kinnison/macadamia/proto1/Lumberg-010599_06.step

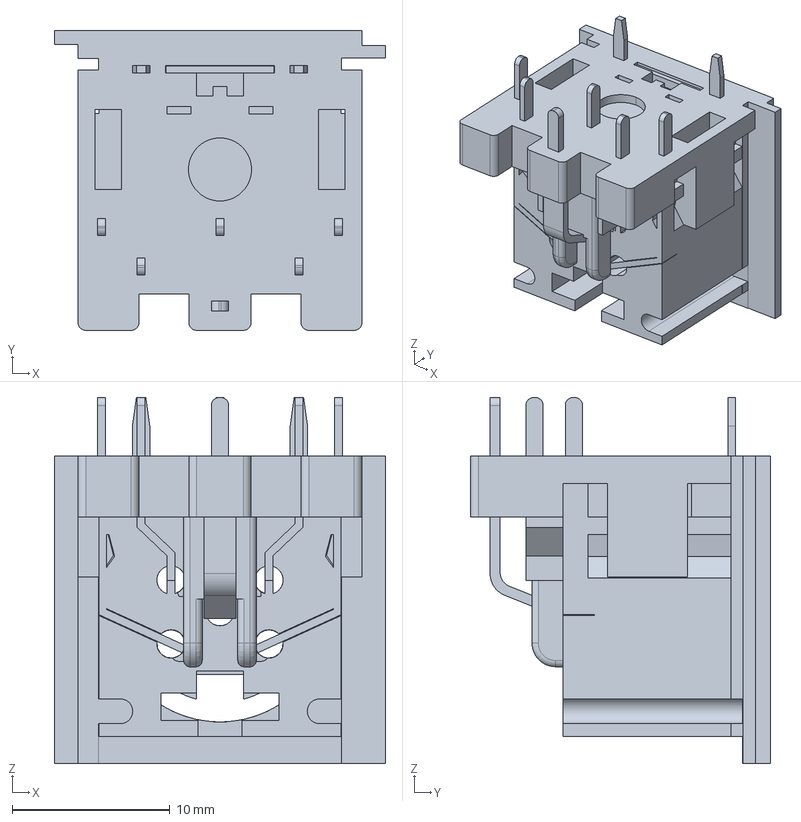
[picture p1: CAD file, 2025-01-01]
proto1/Lumberg-010599_06.step
21.0 x 19.0 x 23.2 mm
