kinnison/macadamia/proto1/macadamia.kicad_pcb

## KiCad design proto1/macadamia.kicad_pcb (2025-01-03)

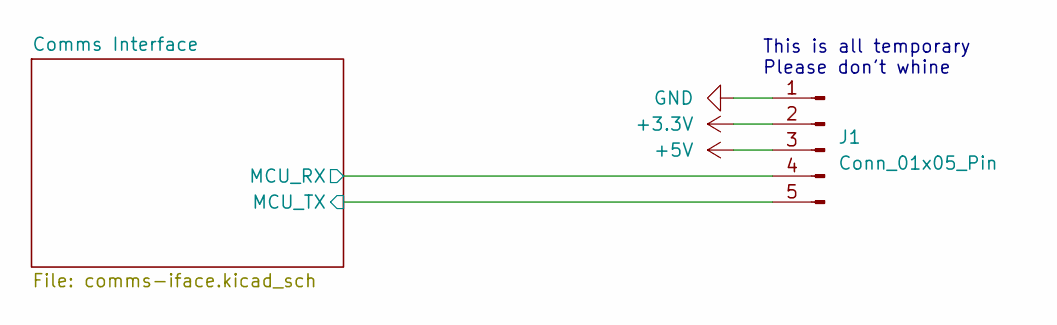
[picture p2: schematic macadamia.kicad_sch, Macadamia - Top Level]

Parts:
J1: Conn_01x05_Pin; PinHeader_1x05_P2.54mm_Vertical

Connections:
+3.3V: J1.2; also elsewhere on the board
+5V: J1.3; also elsewhere on the board
/Comms Interface/MCU_RX: J1.4; also elsewhere on the board
/Comms Interface/MCU_TX: J1.5; also elsewhere on the board
GND: J1.1; also elsewhere on the board

Notes on the sheet:
This is all temporary Please don't whine

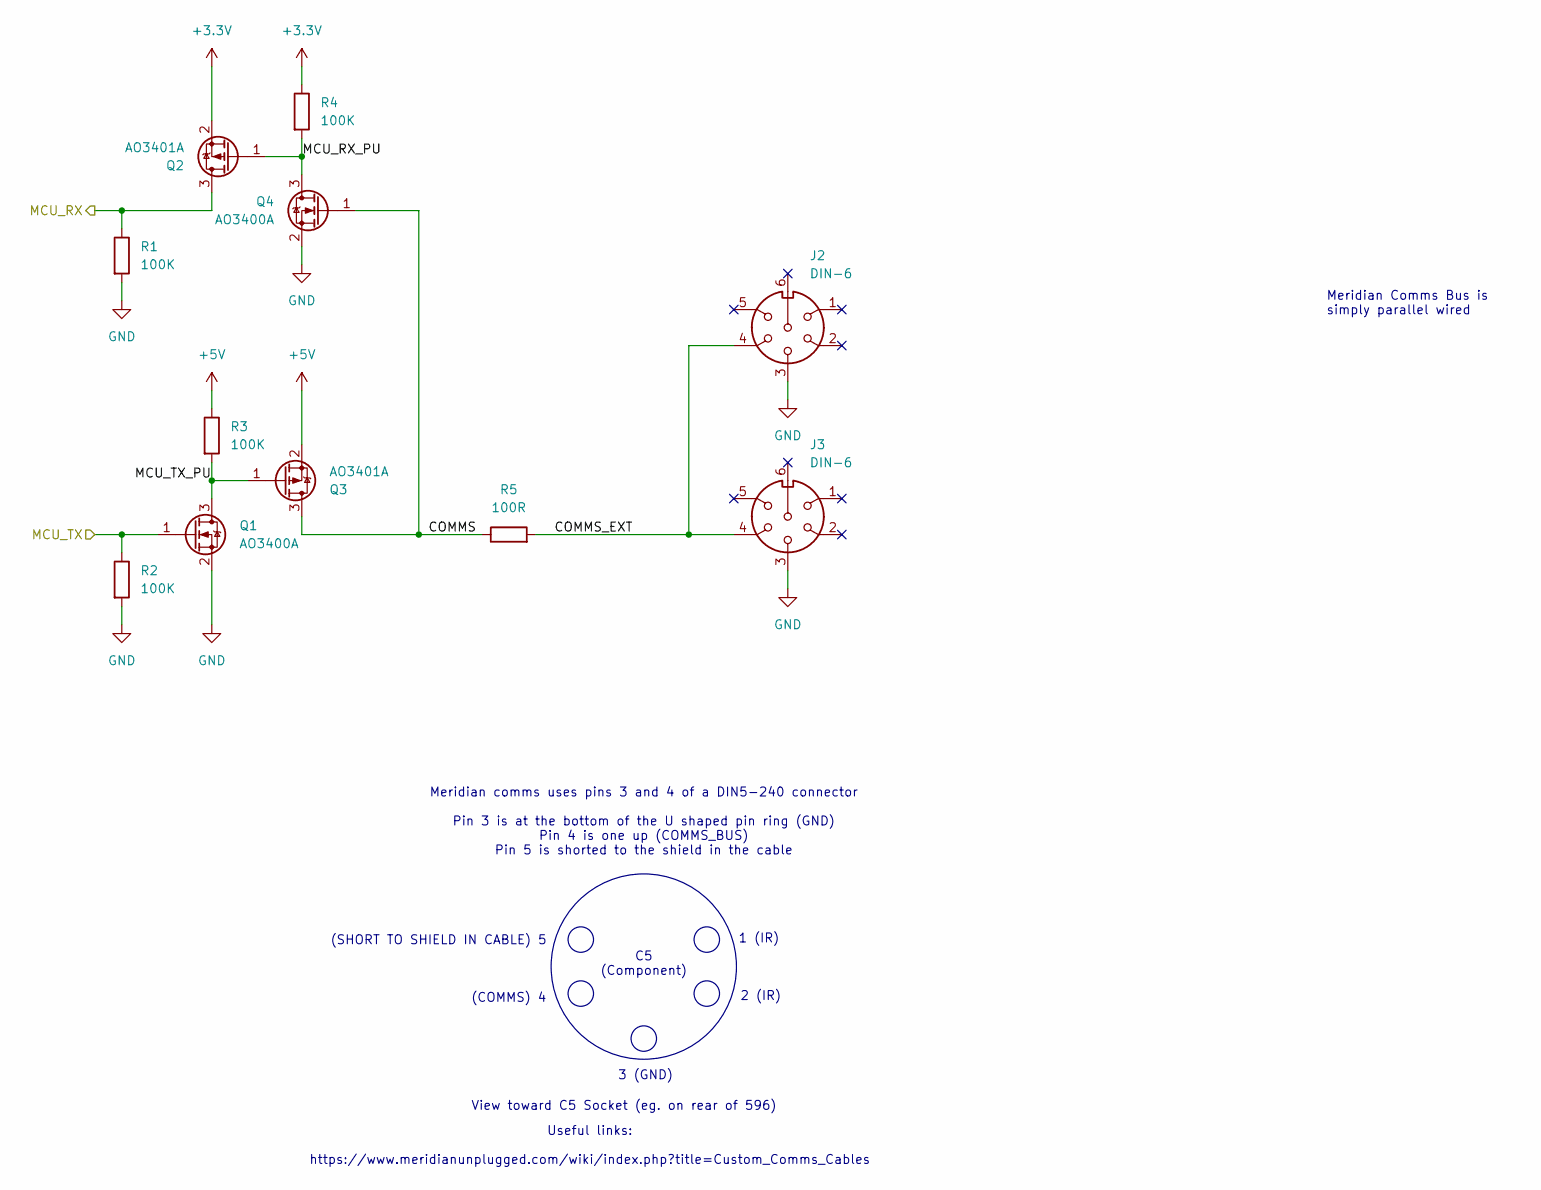
[picture p3: schematic comms-iface.kicad_sch, Comms Bus Interface]

Parts:
J2, J3: DIN-6; DIN-45322-010599-06
Q1, Q4: AO3400A; SOT-23-3; JLCPCB Part # C20917
Q2, Q3: AO3401A; SOT-23-3; JLCPCB Part # C15127
R1, R2, R3, R4: 100K; R_0603_1608Metric; JLCPCB Part # C25803
R5: 100R; R_0603_1608Metric; JLCPCB Part # C22775

Connections:
+3.3V: Q2.2 (S), R4.1; also elsewhere on the board
+5V: Q3.2 (S), R3.1; also elsewhere on the board
/Comms Interface/COMMS: Q3.3 (D), Q4.1 (G), R5.1
/Comms Interface/COMMS_EXT: J2.4, J3.4, R5.2
/Comms Interface/MCU_RX: Q2.3 (D), R1.1; also elsewhere on the board
/Comms Interface/MCU_RX_PU: Q2.1 (G), Q4.3 (D), R4.2
/Comms Interface/MCU_TX: Q1.1 (G), R2.1; also elsewhere on the board
/Comms Interface/MCU_TX_PU: Q1.3 (D), Q3.1 (G), R3.2
GND: J2.3, J3.3, Q1.2 (S), Q4.2 (S), R1.2, R2.2; also elsewhere on the board

Notes on the sheet:
3 (GND)
Useful links: https://www.meridianunplugged.com/wiki/index.php?title=Custom_Comms_Cables
(SHORT TO SHIELD IN CABLE) 5
1 (IR)
(COMMS) 4
Meridian Comms Bus is simply parallel wired
2 (IR)
View toward C5 Socket (eg. on rear of 596)
Meridian comms uses pins 3 and 4 of a DIN5-240 connector Pin 3 is at the bottom of the U shaped pin ring (GND) Pin 4 is one up (COMMS_BUS) Pin 5 is shorted to the shield in the cable
C5 (Component)

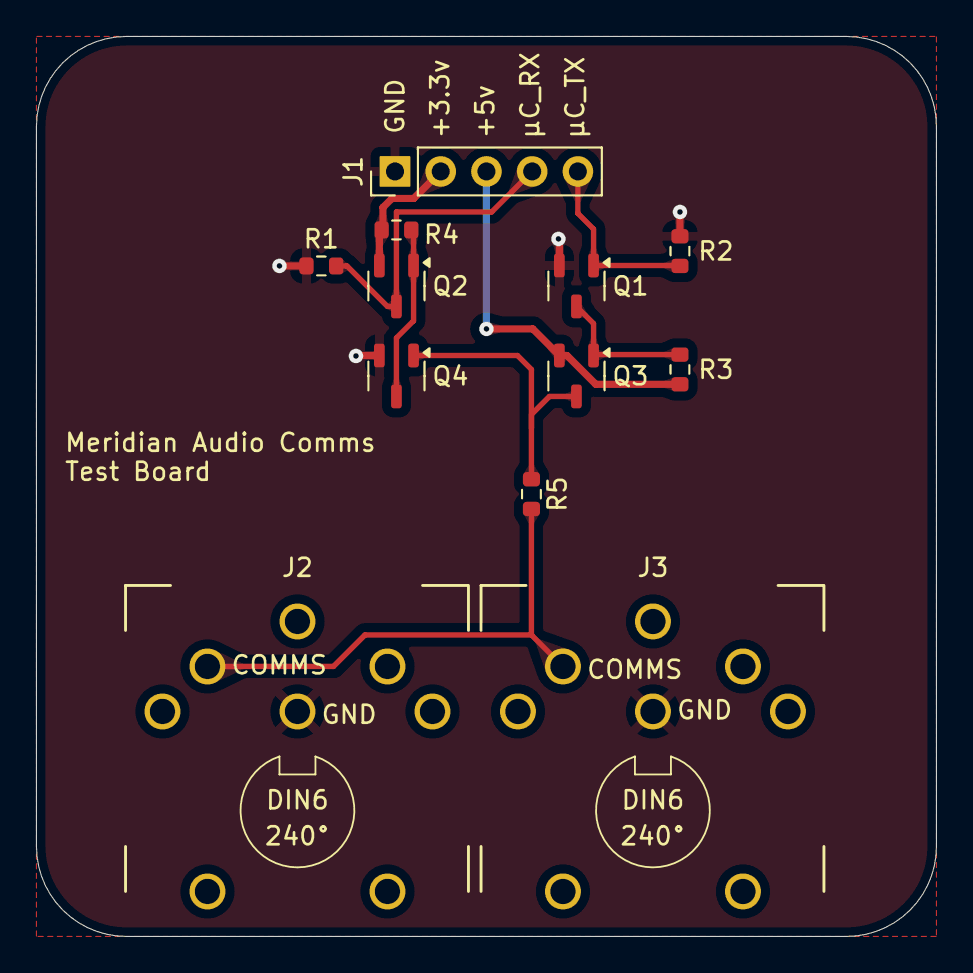
[picture p4: board macadamia.kicad_pcb from above]

Board: 2 copper layers, 50.0 x 50.0 mm, 12 parts (0 on the bottom side), 9 nets.
