kinnison/macadamia/(commit log)

2025-01-01 chore: Initial stuff before I begin
    [macadamia.kicad_pcb, macadamia.kicad_sch]
2025-01-01 proto1: Close to done
    [Lumberg-010599_06.step, comms-iface.kicad_sch, macadamia.kicad_pcb, macadamia.kicad_sch]
2025-01-03 proto1: Fix pfet orientation
    [comms-iface.kicad_sch, macadamia.kicad_pcb]
2025-01-03 proto1-code: Framework, not building yet
